davidmpye/snackbot/vmc-host/src/images/doritos_cheese.jpg

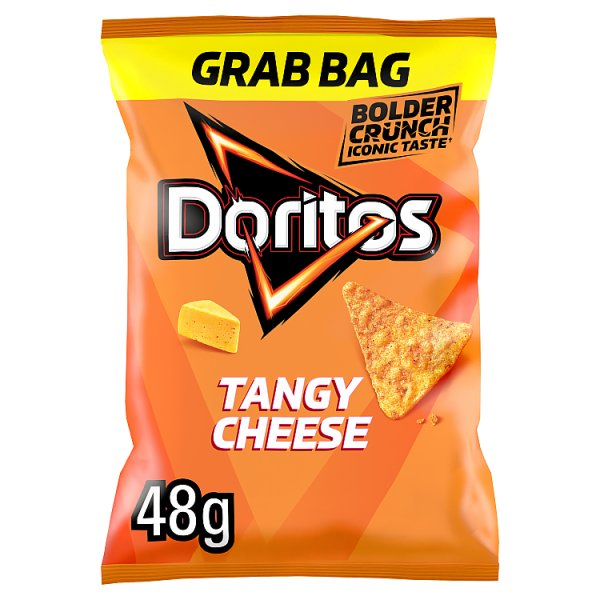
vmc-host/src/images/doritos_cheese.jpg
