davidmpye/snackbot/vmc-host/src/images/chilli_peanuts.jpg

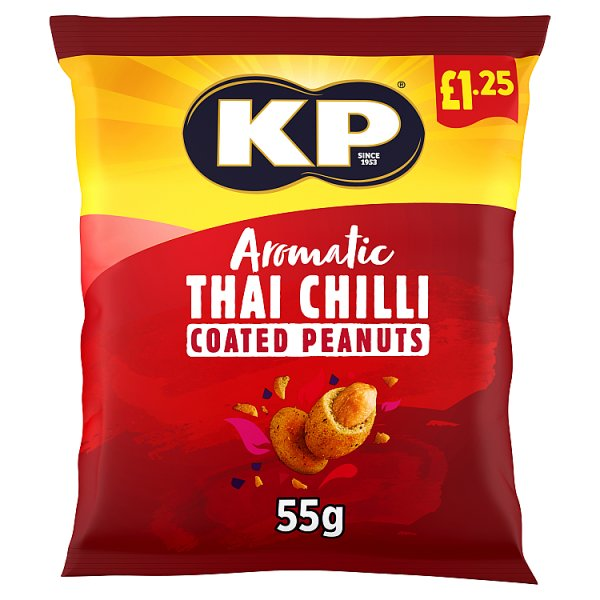
vmc-host/src/images/chilli_peanuts.jpg
