davidmpye/snackbot/vmc-host/src/images/chipsticks.jpg

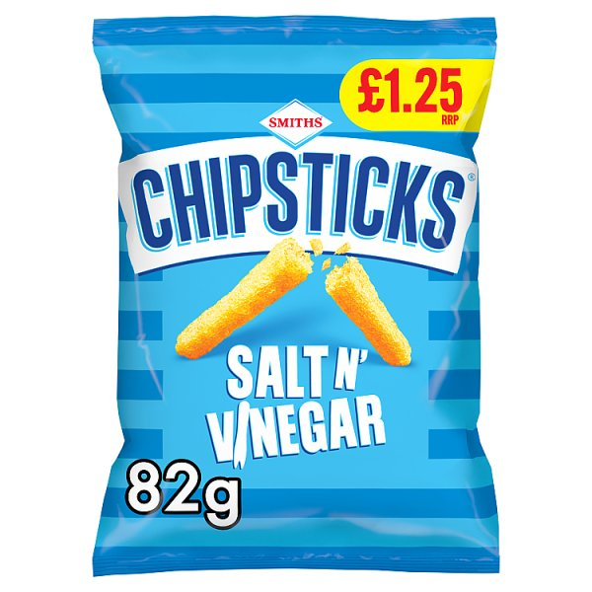
vmc-host/src/images/chipsticks.jpg
