davidmpye/snackbot/vmc-host/src/images/crinklies.jpg

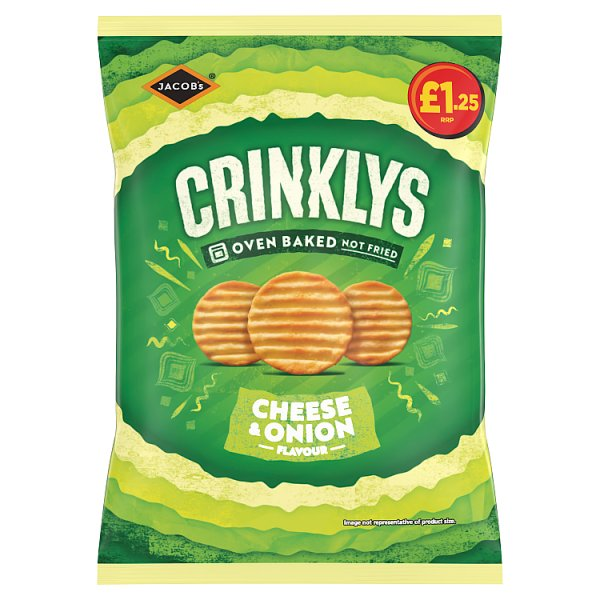
vmc-host/src/images/crinklies.jpg
