davidmpye/snackbot/vmc-host/src/images/doritos_heatwave.jpg

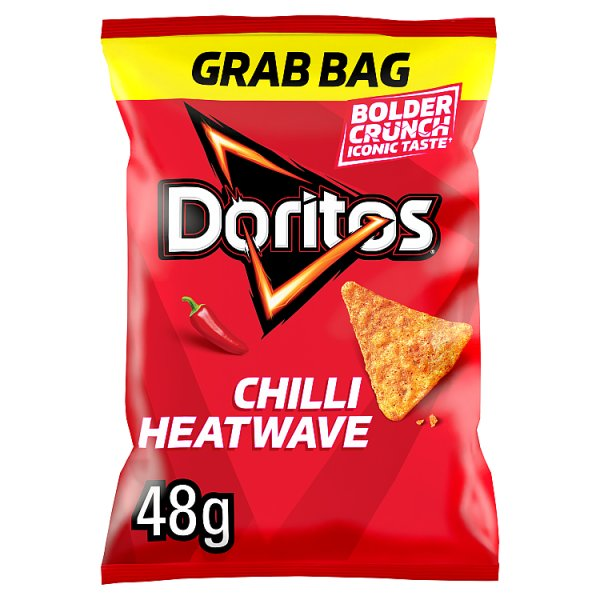
vmc-host/src/images/doritos_heatwave.jpg
