davidmpye/snackbot/vmc-host/src/images/nutrageous.jpg

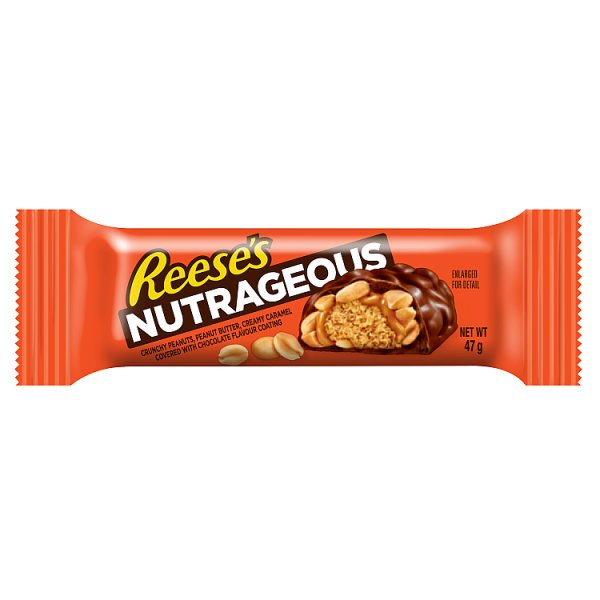
vmc-host/src/images/nutrageous.jpg
