davidmpye/snackbot/vmc-host/src/images/peanut_butter_cups.jpg

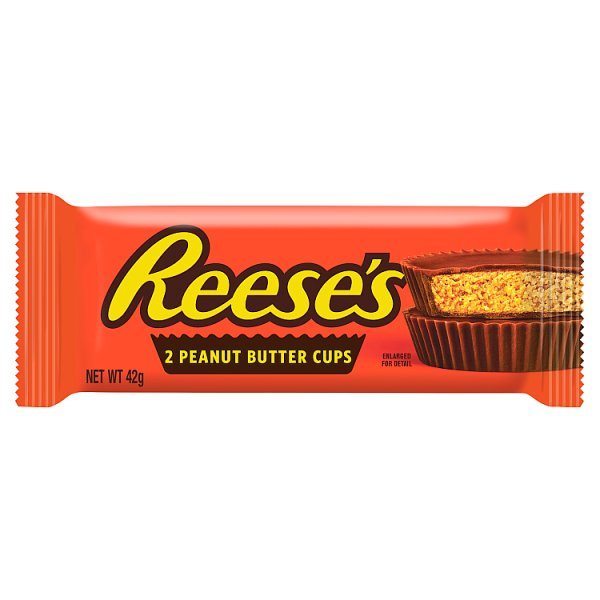
vmc-host/src/images/peanut_butter_cups.jpg
