davidmpye/snackbot/vmc-host/src/images/scampi_fries.jpg

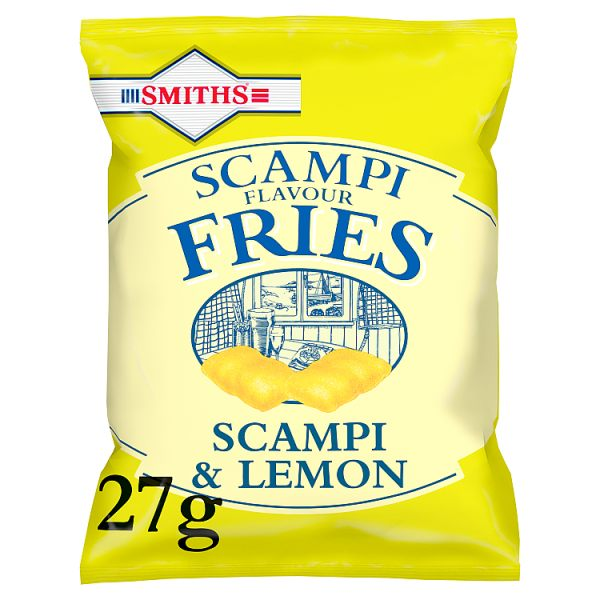
vmc-host/src/images/scampi_fries.jpg
