davidmpye/snackbot/fixings/hyperpixel_lcd_window.scad

square([91, 116]);
//This works!
