davidmpye/snackbot/fixings/i2c_lcd_window.scad

square([89.75, 34.5]);
//This works!
