davidmpye/snackbot/vmc/pcb/pcb.kicad_pcb

## KiCad design vmc/pcb/pcb.kicad_pcb (2025-05-13)

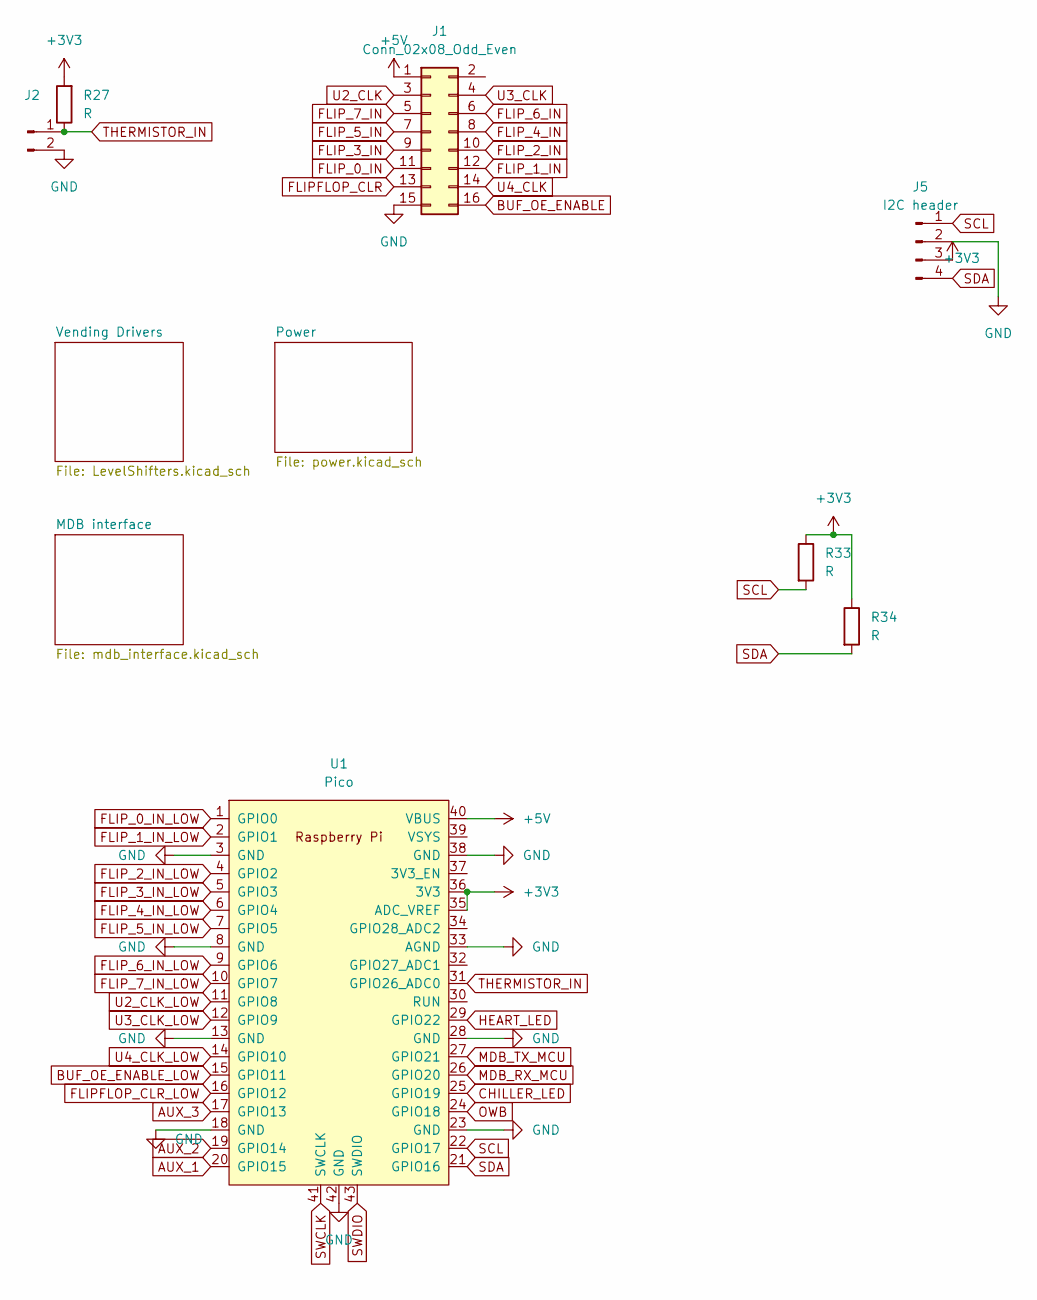
[picture p9: schematic pcb.kicad_sch]

Parts:
J1: Conn_02x08_Odd_Even; PinHeader_2x08_P2.54mm_Vertical
J2: Conn_01x02_Pin; JST_PH_B2B-PH-K_1x02_P2.00mm_Vertical
J5: I2C header; PinHeader_1x04_P2.54mm_Vertical
R27, R33, R34: R; R_1206_3216Metric
U1: Pico; RPi_Pico_SMD_TH

Connections:
+3V3: J5.3, R27.2, R33.1, R34.1, U1.35 (ADC_VREF), U1.36 (3V3); also elsewhere on the board
+5V: J1.1, U1.40 (VBUS); also elsewhere on the board
AUX_1: U1.20 (GPIO15); also elsewhere on the board
AUX_2: U1.19 (GPIO14); also elsewhere on the board
AUX_3: U1.17 (GPIO13); also elsewhere on the board
BUF_OE_ENABLE: J1.16; also elsewhere on the board
BUF_OE_ENABLE_LOW: U1.15 (GPIO11); also elsewhere on the board
CHILLER_LED: U1.25 (GPIO19); also elsewhere on the board
FLIPFLOP_CLR: J1.13; also elsewhere on the board
FLIPFLOP_CLR_LOW: U1.16 (GPIO12); also elsewhere on the board
FLIP_0_IN: J1.11; also elsewhere on the board
FLIP_0_IN_LOW: U1.1 (GPIO0); also elsewhere on the board
FLIP_1_IN: J1.12; also elsewhere on the board
FLIP_1_IN_LOW: U1.2 (GPIO1); also elsewhere on the board
FLIP_2_IN: J1.10; also elsewhere on the board
FLIP_2_IN_LOW: U1.4 (GPIO2); also elsewhere on the board
FLIP_3_IN: J1.9; also elsewhere on the board
FLIP_3_IN_LOW: U1.5 (GPIO3); also elsewhere on the board
FLIP_4_IN: J1.8; also elsewhere on the board
FLIP_4_IN_LOW: U1.6 (GPIO4); also elsewhere on the board
FLIP_5_IN: J1.7; also elsewhere on the board
FLIP_5_IN_LOW: U1.7 (GPIO5); also elsewhere on the board
FLIP_6_IN: J1.6; also elsewhere on the board
FLIP_6_IN_LOW: U1.9 (GPIO6); also elsewhere on the board
FLIP_7_IN: J1.5; also elsewhere on the board
FLIP_7_IN_LOW: U1.10 (GPIO7); also elsewhere on the board
GND: J1.15, J2.2, J5.2, U1.3 (GND), U1.8 (GND), U1.13 (GND), U1.18 (GND), U1.23 (GND), U1.28 (GND), U1.33 (AGND), U1.38 (GND), U1.42 (GND); also elsewhere on the board
HEART_LED: U1.29 (GPIO22); also elsewhere on the board
MDB_RX_MCU: U1.26 (GPIO20); also elsewhere on the board
MDB_TX_MCU: U1.27 (GPIO21); also elsewhere on the board
OWB: U1.24 (GPIO18); also elsewhere on the board
SCL: J5.1, R33.2, U1.22 (GPIO17)
SDA: J5.4, R34.2, U1.21 (GPIO16)
SWCLK: U1.41 (SWCLK); also elsewhere on the board
SWDIO: U1.43 (SWDIO); also elsewhere on the board
THERMISTOR_IN: J2.1, R27.1, U1.31 (GPIO26_ADC0)
U2_CLK: J1.3; also elsewhere on the board
U2_CLK_LOW: U1.11 (GPIO8); also elsewhere on the board
U3_CLK: J1.4; also elsewhere on the board
U3_CLK_LOW: U1.12 (GPIO9); also elsewhere on the board
U4_CLK: J1.14; also elsewhere on the board
U4_CLK_LOW: U1.14 (GPIO10); also elsewhere on the board

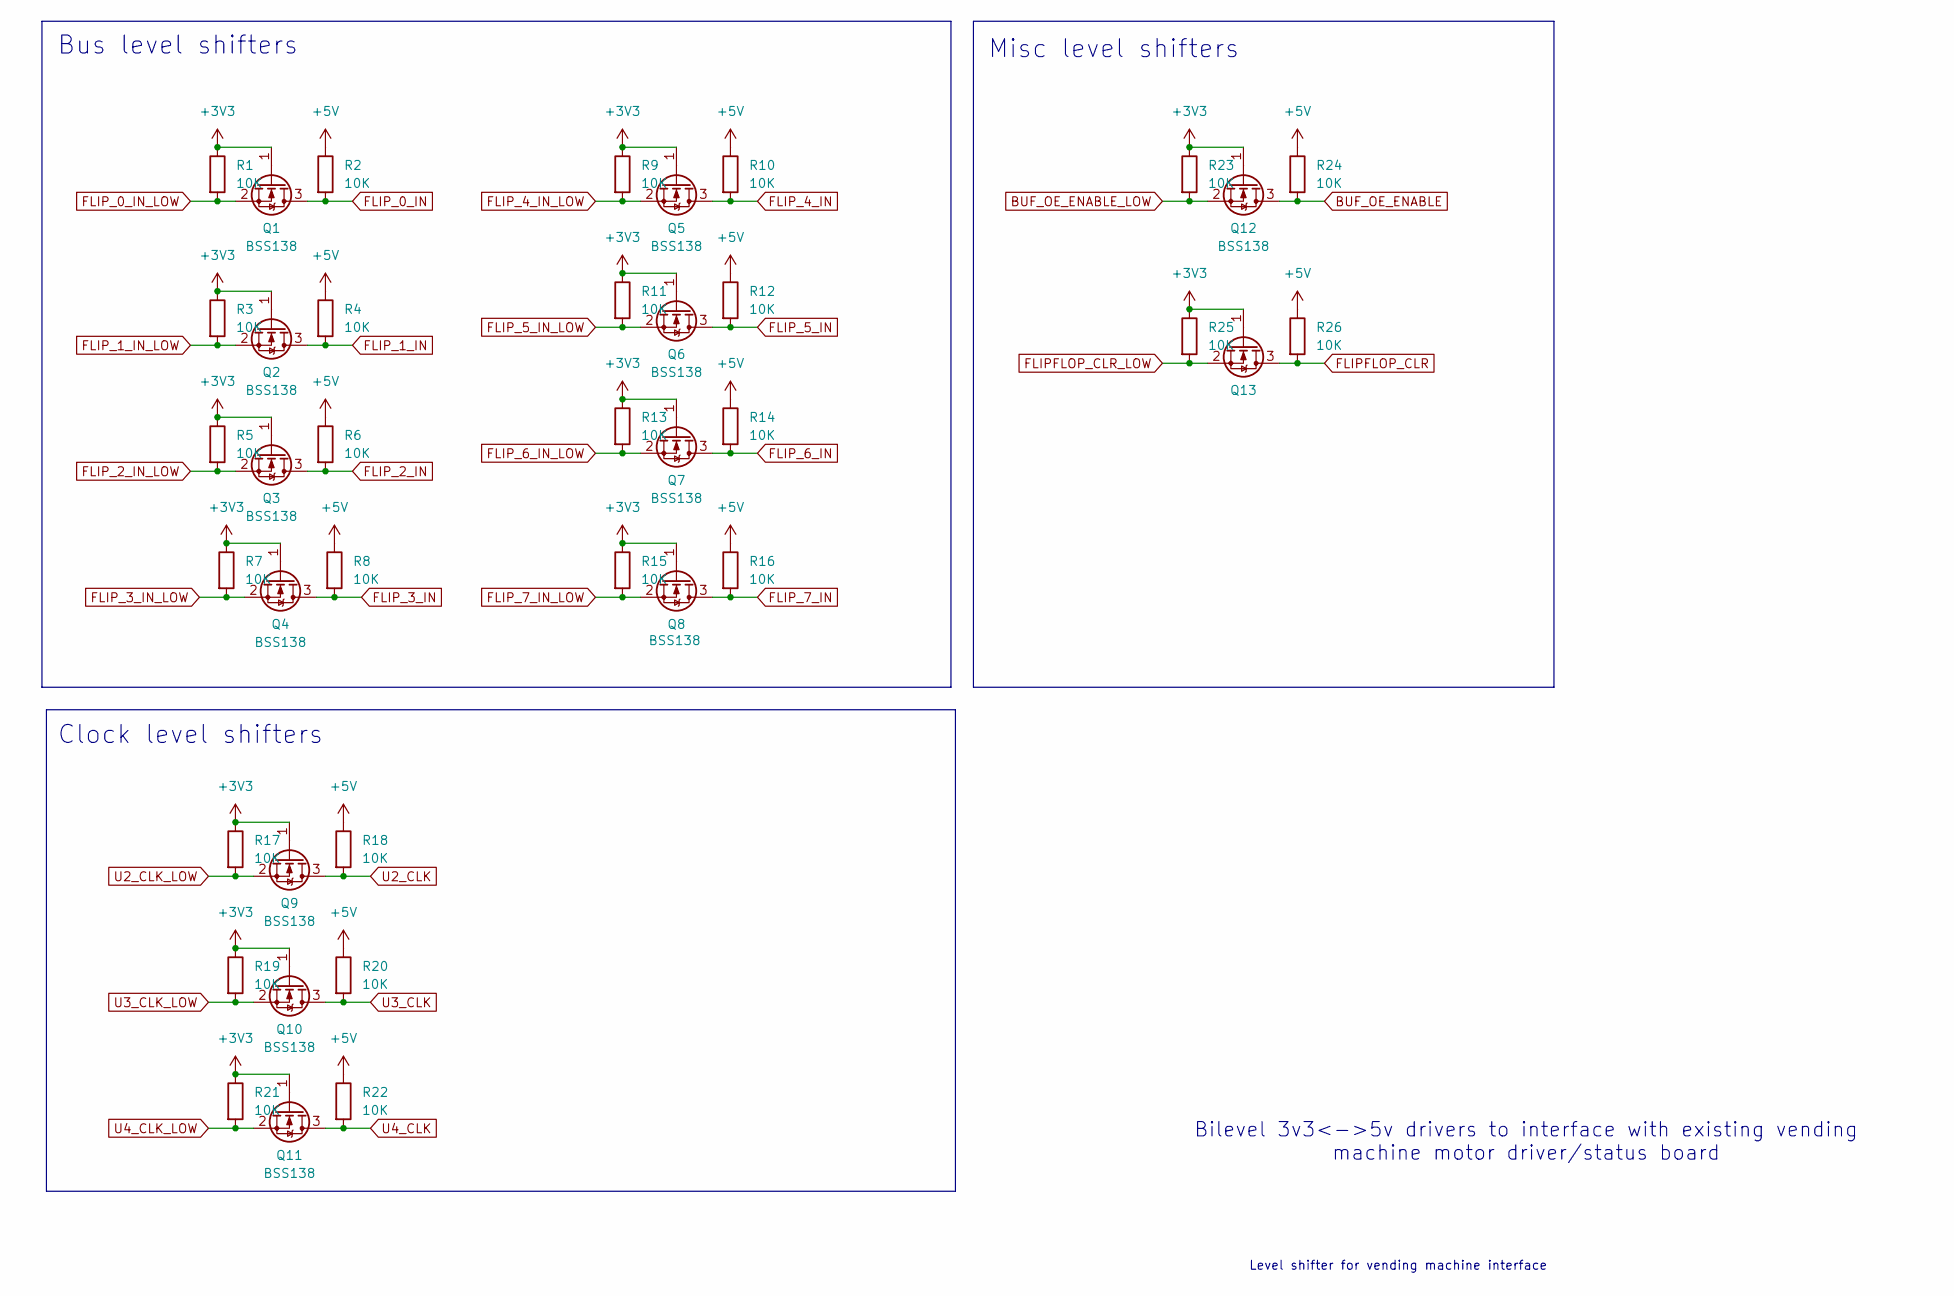
[picture p10: schematic LevelShifters.kicad_sch]

Parts:
Q1, Q2, Q3, Q4, Q5, Q6, Q7, Q8, Q9, Q10, Q11, Q12, Q13: BSS138; SOT-23
R1, R2, R3, R4, R5, R6, R7, R8, R9, R10, R11, R12, R13, R14, R15, R16, R17, R18, R19, R20, R21, R22, R23, R24, R25, R26: 10K; R_1206_3216Metric

Connections:
+3V3: Q1.1 (G), Q2.1 (G), Q3.1 (G), Q4.1 (G), Q5.1 (G), Q6.1 (G), Q7.1 (G), Q8.1 (G), Q9.1 (G), Q10.1 (G), Q11.1 (G), Q12.1 (G), Q13.1 (G), R1.1, R3.1, R5.1, R7.1, R9.1, R11.1, R13.1, R15.1, R17.1, R19.1, R21.1, R23.1, R25.1; also elsewhere on the board
+5V: R2.1, R4.1, R6.1, R8.1, R10.1, R12.1, R14.1, R16.1, R18.1, R20.1, R22.1, R24.1, R26.1; also elsewhere on the board
BUF_OE_ENABLE: Q12.3 (D), R24.2; also elsewhere on the board
BUF_OE_ENABLE_LOW: Q12.2 (S), R23.2; also elsewhere on the board
FLIPFLOP_CLR: Q13.3 (D), R26.2; also elsewhere on the board
FLIPFLOP_CLR_LOW: Q13.2 (S), R25.2; also elsewhere on the board
FLIP_0_IN: Q1.3 (D), R2.2; also elsewhere on the board
FLIP_0_IN_LOW: Q1.2 (S), R1.2; also elsewhere on the board
FLIP_1_IN: Q2.3 (D), R4.2; also elsewhere on the board
FLIP_1_IN_LOW: Q2.2 (S), R3.2; also elsewhere on the board
FLIP_2_IN: Q3.3 (D), R6.2; also elsewhere on the board
FLIP_2_IN_LOW: Q3.2 (S), R5.2; also elsewhere on the board
FLIP_3_IN: Q4.3 (D), R8.2; also elsewhere on the board
FLIP_3_IN_LOW: Q4.2 (S), R7.2; also elsewhere on the board
FLIP_4_IN: Q5.3 (D), R10.2; also elsewhere on the board
FLIP_4_IN_LOW: Q5.2 (S), R9.2; also elsewhere on the board
FLIP_5_IN: Q6.3 (D), R12.2; also elsewhere on the board
FLIP_5_IN_LOW: Q6.2 (S), R11.2; also elsewhere on the board
FLIP_6_IN: Q7.3 (D), R14.2; also elsewhere on the board
FLIP_6_IN_LOW: Q7.2 (S), R13.2; also elsewhere on the board
FLIP_7_IN: Q8.3 (D), R16.2; also elsewhere on the board
FLIP_7_IN_LOW: Q8.2 (S), R15.2; also elsewhere on the board
U2_CLK: Q9.3 (D), R18.2; also elsewhere on the board
U2_CLK_LOW: Q9.2 (S), R17.2; also elsewhere on the board
U3_CLK: Q10.3 (D), R20.2; also elsewhere on the board
U3_CLK_LOW: Q10.2 (S), R19.2; also elsewhere on the board
U4_CLK: Q11.3 (D), R22.2; also elsewhere on the board
U4_CLK_LOW: Q11.2 (S), R21.2; also elsewhere on the board

Notes on the sheet:
Bilevel 3v3<->5v drivers to interface with existing vending machine motor driver/status board
Level shifter for vending machine interface
Clock level shifters
Bus level shifters
Misc level shifters

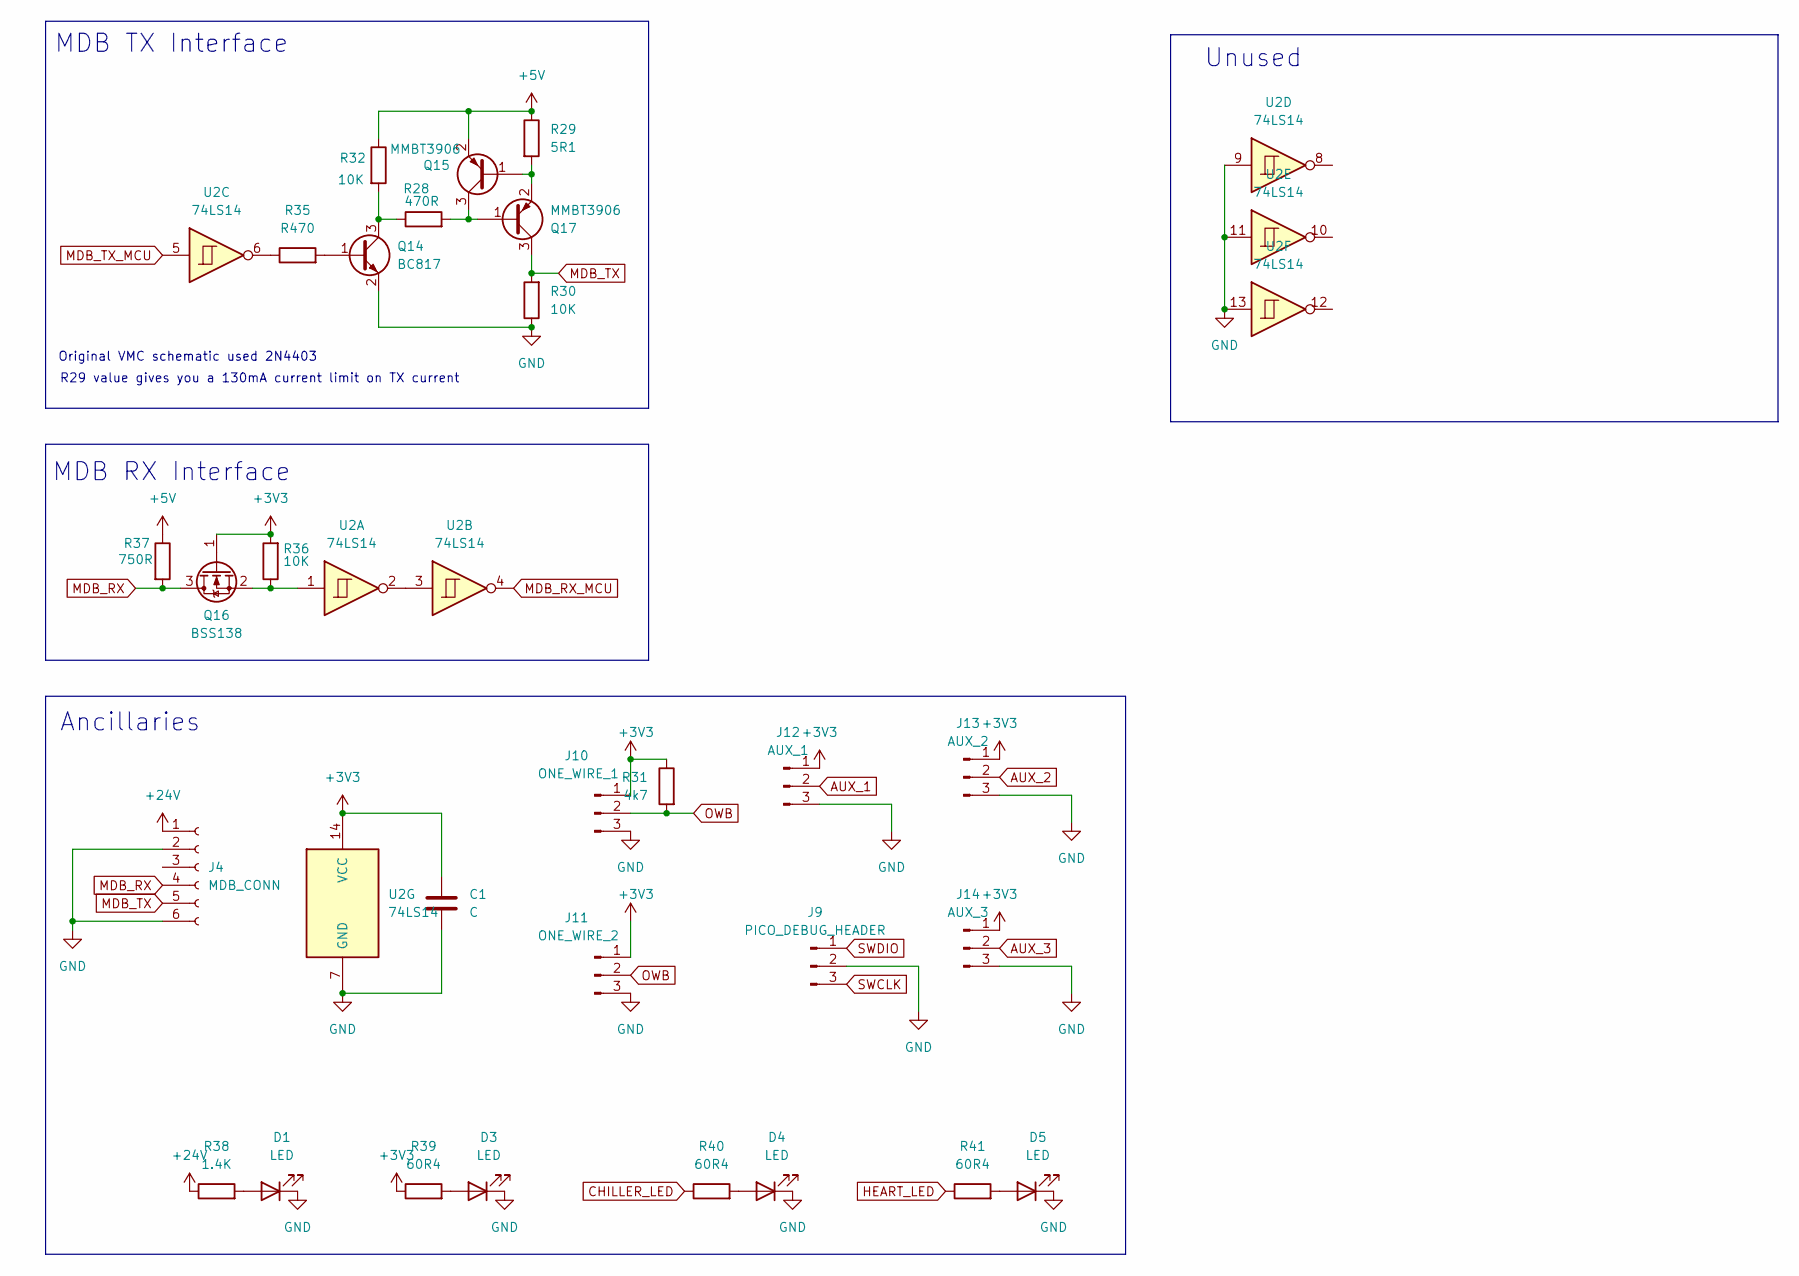
[picture p11: schematic mdb_interface.kicad_sch]

Parts:
C1: C; C_1206_3216Metric
D1, D3, D4, D5: LED; LED_1206_3216Metric_Pad1.42x1.75mm_HandSolder
J4: MDB_CONN; Molex_Mini-Fit_Jr_5566-06A_2x03_P4.20mm_Vertical
J9: PICO_DEBUG_HEADER; PinSocket_1x03_P2.54mm_Vertical
J10: ONE_WIRE_1; JST_PH_B3B-PH-K_1x03_P2.00mm_Vertical
J11: ONE_WIRE_2; JST_PH_B3B-PH-K_1x03_P2.00mm_Vertical
J12: AUX_1; JST_PH_B3B-PH-K_1x03_P2.00mm_Vertical
J13: AUX_2; JST_PH_B3B-PH-K_1x03_P2.00mm_Vertical
J14: AUX_3; JST_PH_B3B-PH-K_1x03_P2.00mm_Vertical
Q14: BC817; SOT-23
Q15, Q17: MMBT3906; SOT-23
Q16: BSS138; SOT-23
R28: 470R; R_1206_3216Metric
R29: 5R1; R_1206_3216Metric
R30, R32, R36: 10K; R_1206_3216Metric
R31: 4k7; R_1206_3216Metric
R35: R470; R_1206_3216Metric
R37: 750R; R_1206_3216Metric
R38: 1.4K; R_1206_3216Metric
R39, R40, R41: 60R4; R_1206_3216Metric
U2: 74LS14; SOIC-14_3.9x8.7mm_P1.27mm

Connections:
+3V3: C1.1, J10.1, J11.1, J12.1, J13.1, J14.1, Q16.1 (G), R31.1, R36.2, R39.1, U2.14 (VCC); also elsewhere on the board
+5V: Q15.2 (E), R29.1, R32.1, R37.1; also elsewhere on the board
+24V: J4.1, R38.1; also elsewhere on the board
AUX_1: J12.2; also elsewhere on the board
AUX_2: J13.2; also elsewhere on the board
AUX_3: J14.2; also elsewhere on the board
CHILLER_LED: R40.1; also elsewhere on the board
GND: C1.2, D1.1 (K), D3.1 (K), D4.1 (K), D5.1 (K), J4.2, J4.6, J9.2, J10.3, J11.3, J12.3, J13.3, J14.3, Q14.2 (E), R30.1, U2.7 (GND), U2.9, U2.11, U2.13; also elsewhere on the board
HEART_LED: R41.1; also elsewhere on the board
MDB_RX: J4.4, Q16.3 (D), R37.2
MDB_RX_MCU: U2.4; also elsewhere on the board
MDB_TX: J4.5, Q17.3 (C), R30.2
MDB_TX_MCU: U2.5; also elsewhere on the board
unnamed: D1.2 (A), R38.2
unnamed: D3.2 (A), R39.2
unnamed: D4.2 (A), R40.2
unnamed: D5.2 (A), R41.2
unnamed: Q14.1 (B), R35.2
unnamed: Q14.3 (C), R28.1, R32.2
unnamed: Q15.1 (B), Q17.2 (E), R29.2
unnamed: Q15.3 (C), Q17.1 (B), R28.2
unnamed: Q16.2 (S), R36.1, U2.1
unnamed: R35.1, U2.6
unnamed: U2.2, U2.3
OWB: J10.2, J11.2, R31.2; also elsewhere on the board
SWCLK: J9.3; also elsewhere on the board
SWDIO: J9.1; also elsewhere on the board

Notes on the sheet:
MDB RX Interface
MDB TX Interface
R29 value gives you a 130mA current limit on TX current
Ancillaries
Unused
Original VMC schematic used 2N4403

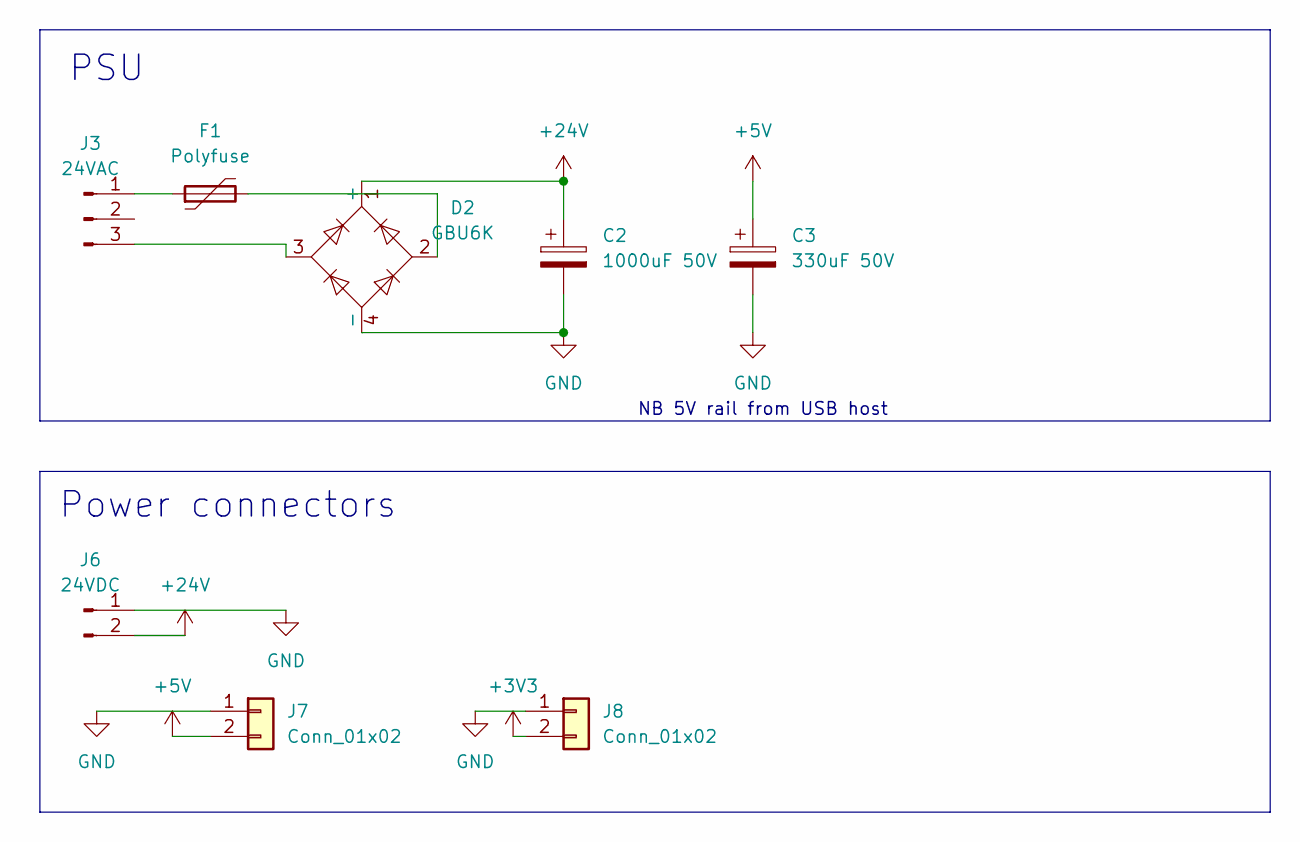
[picture p12: schematic power.kicad_sch]

Parts:
C2: 1000uF 50V; CP_Radial_D12.5mm_P5.00mm
C3: 330uF 50V; CP_Radial_D10.0mm_P5.00mm
D2: GBU6K; Diode_Bridge_Vishay_GBU
F1: Polyfuse; FUS_RKEF300_TYCO_TYC
J3: 24VAC; JST_VH_B3P-VH-B_1x03_P3.96mm_Vertical
J6: 24VDC; JST_VH_B2P-VH_1x02_P3.96mm_Vertical
J7, J8: Conn_01x02; PinHeader_1x02_P2.54mm_Vertical

Connections:
+3V3: J8.2; also elsewhere on the board
+5V: C3.1, J7.2; also elsewhere on the board
+24V: C2.1, D2.1 (+), J6.2; also elsewhere on the board
GND: C2.2, C3.2, D2.4 (-), J6.1, J7.1, J8.1; also elsewhere on the board
unnamed: D2.2, F1.2
unnamed: F1.1, J3.1
unnamed: D2.3, J3.3

Notes on the sheet:
PSU
NB 5V rail from USB host
Power connectors

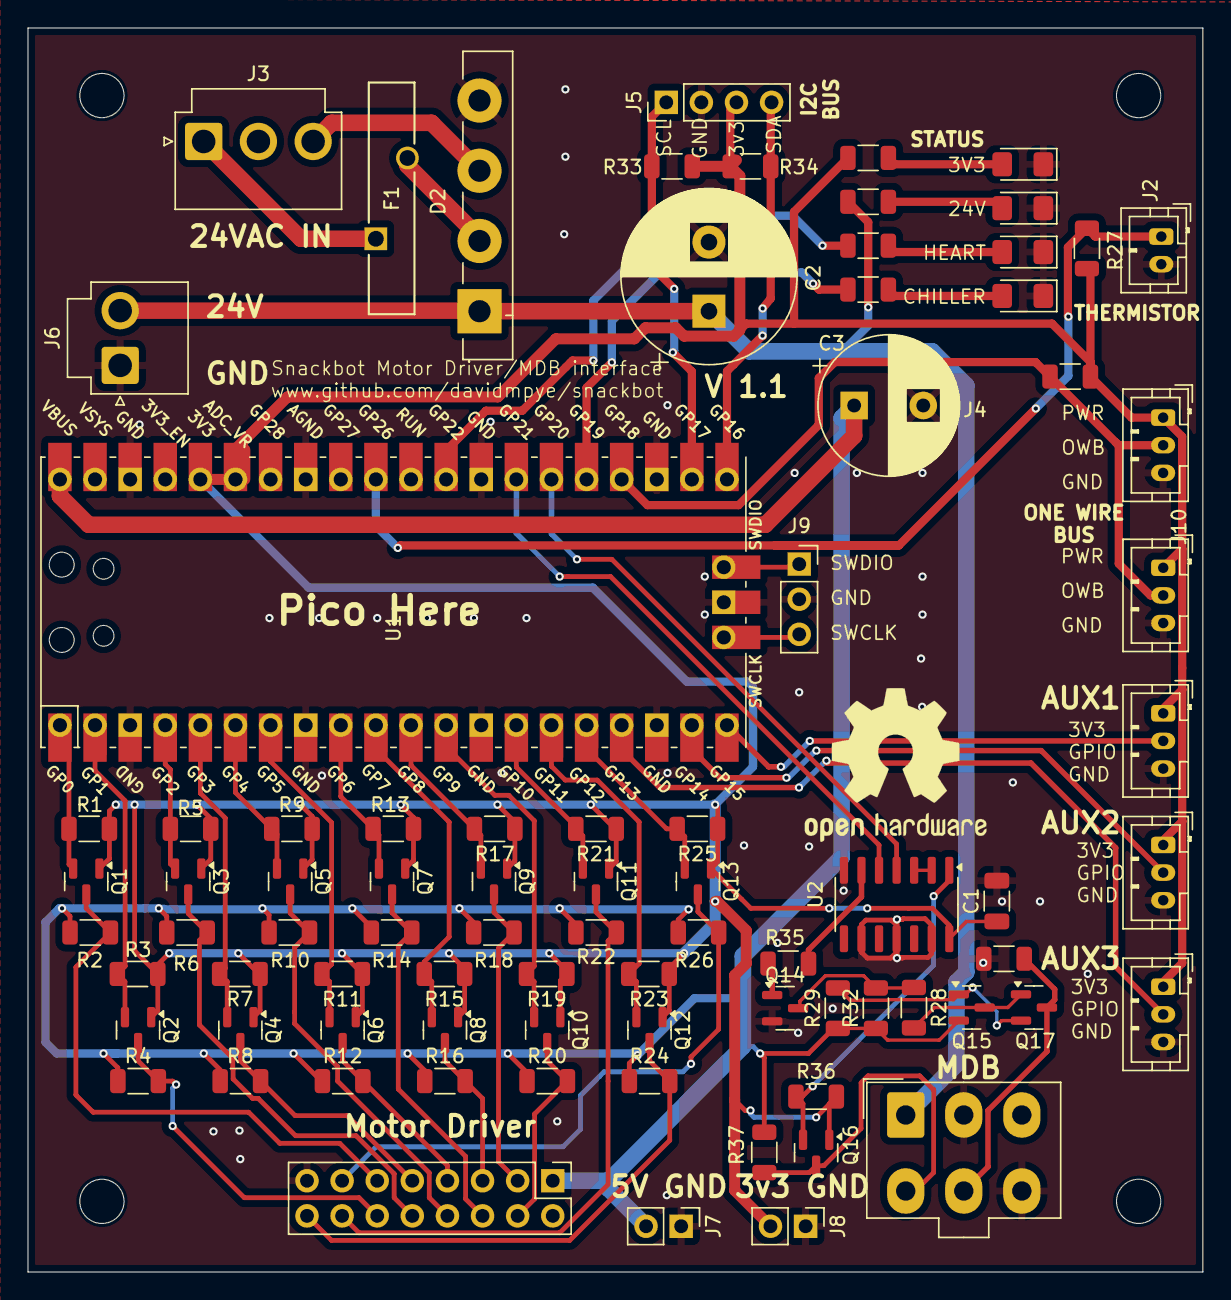
[picture p13: board pcb.kicad_pcb from above]

Board: 2 copper layers, 85.0 x 90.0 mm, 83 parts (0 on the bottom side), 59 nets.
