davidmpye/snackbot/matrix-keyboard/pcb/MembraneKeyboard.kicad_pcb

## KiCad design matrix-keyboard/pcb/MembraneKeyboard.kicad_pcb (2024-12-24)

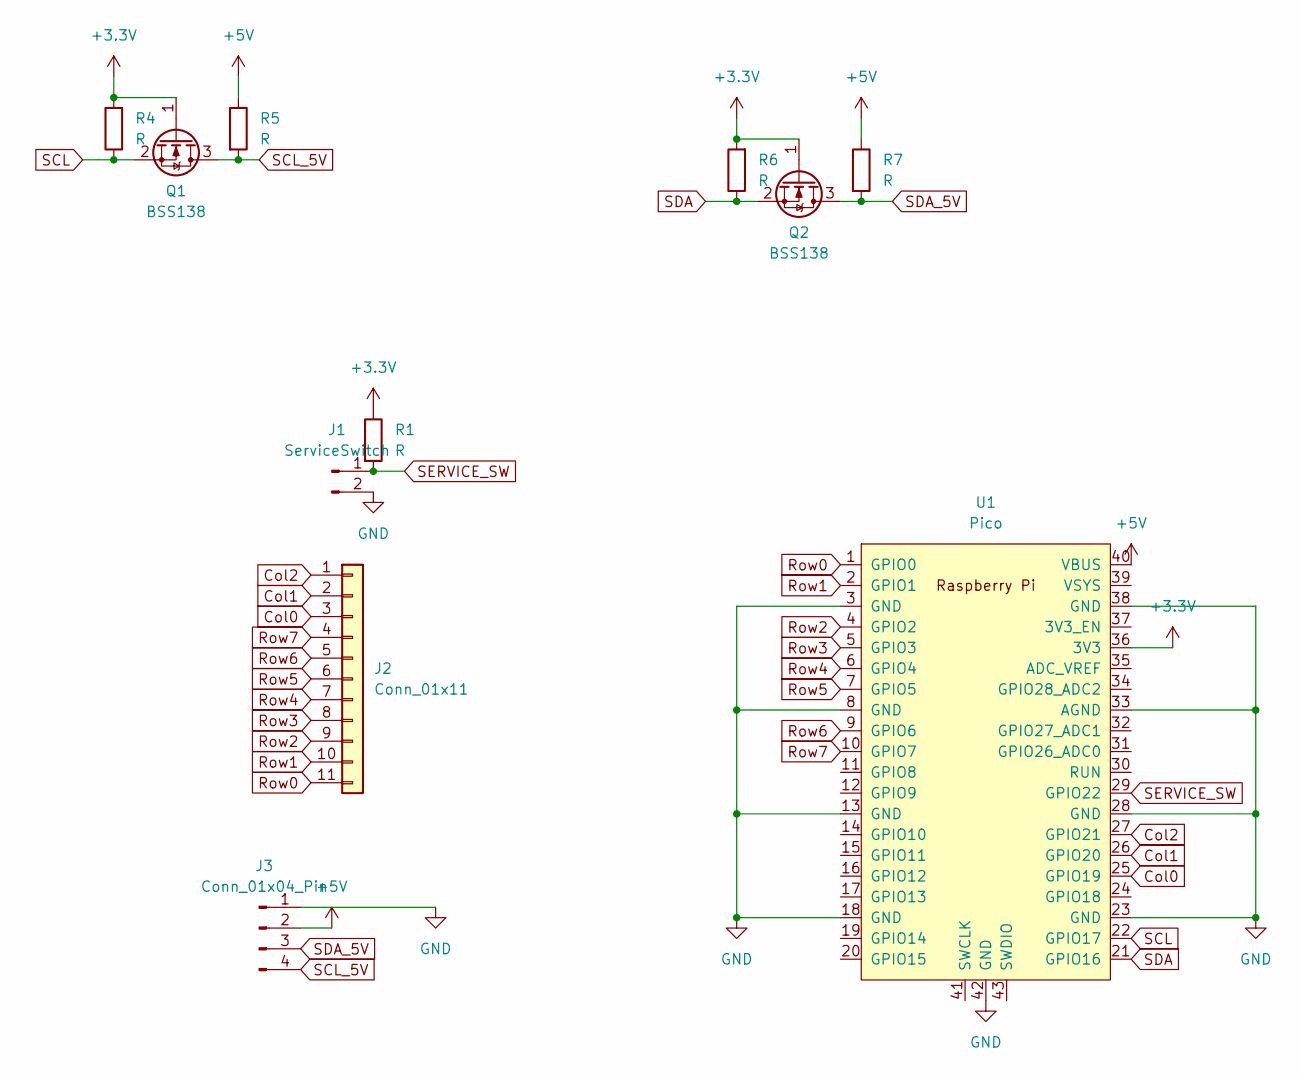
[picture p14: schematic MembraneKeyboard.kicad_sch]

Parts:
J1: ServiceSwitch; PinHeader_1x02_P2.54mm_Vertical
J2: Conn_01x11; PinHeader_1x11_P2.54mm_Vertical
J3: Conn_01x04_Pin; PinHeader_1x04_P2.54mm_Vertical
Q1, Q2: BSS138; SOT-23
R1, R4, R5, R6, R7: R; R_1206_3216Metric
U1: Pico; RPi_Pico_SMD_TH

Connections:
+3.3V: Q1.1 (G), Q2.1 (G), R1.1, R4.2, R6.2, U1.36 (3V3)
+5V: J3.2, R5.1, R7.1, U1.40 (VBUS)
Col0: J2.3, U1.25 (GPIO19)
Col1: J2.2, U1.26 (GPIO20)
Col2: J2.1, U1.27 (GPIO21)
GND: J1.2, J3.1, U1.3 (GND), U1.8 (GND), U1.13 (GND), U1.18 (GND), U1.23 (GND), U1.28 (GND), U1.33 (AGND), U1.38 (GND), U1.42 (GND)
Row0: J2.11, U1.1 (GPIO0)
Row1: J2.10, U1.2 (GPIO1)
Row2: J2.9, U1.4 (GPIO2)
Row3: J2.8, U1.5 (GPIO3)
Row4: J2.7, U1.6 (GPIO4)
Row5: J2.6, U1.7 (GPIO5)
Row6: J2.5, U1.9 (GPIO6)
Row7: J2.4, U1.10 (GPIO7)
SCL: Q1.2 (S), R4.1, U1.22 (GPIO17)
SCL_5V: J3.4, Q1.3 (D), R5.2
SDA: Q2.2 (S), R6.1, U1.21 (GPIO16)
SDA_5V: J3.3, Q2.3 (D), R7.2
SERVICE_SW: J1.1, R1.2, U1.29 (GPIO22)

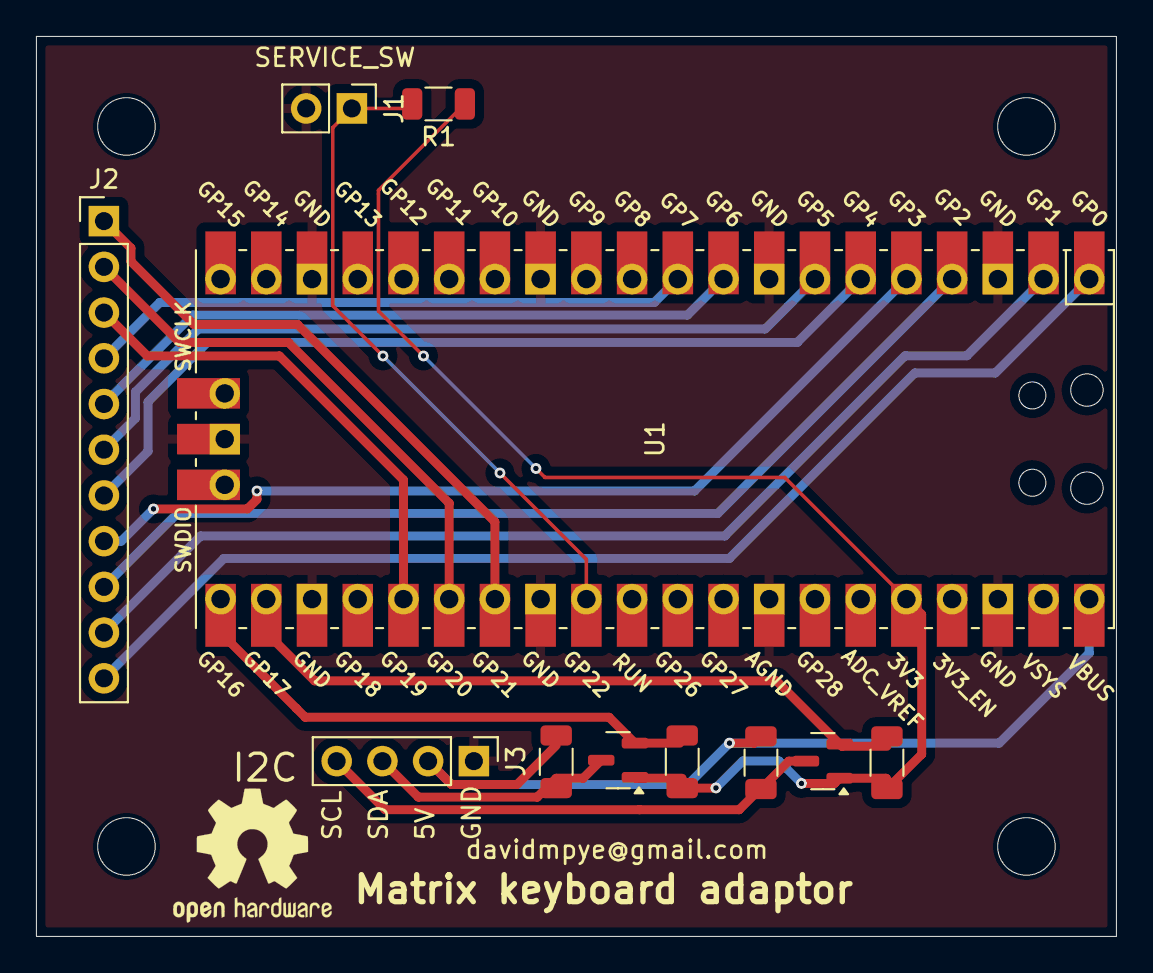
[picture p15: board MembraneKeyboard.kicad_pcb from above]

Board: 2 copper layers, 60.0 x 50.0 mm, 11 parts (0 on the bottom side), 19 nets.
