davidmpye/snackbot/vmc/fw/src/vmc.rs

use embassy_time::{Duration, Timer, with_timeout};
use postcard_rpc::header::VarHeader;

use vmc_icd::{Vend, VendCommand, VendError, VendResult, VendProgress, VendProgressTopic, ItemAvailable, ForceDispense};

use crate::motor_driver::DispenserAddress;

use crate::{AppTx, Sender, SpawnCtx};

use crate::Context;

use defmt::*;

use crate::DISPENSER_DRIVER;
use crate::cashless_device::{CashlessDeviceCommand, CashlessDeviceResponse, CASHLESS_COMMAND_SIGNAL, CASHLESS_RESPONSE_SIGNAL};

static PAYMENT_TIMEOUT:Duration = Duration::from_secs(30);

enum PaymentType {
    Cash(u16),//amount received
    Card(u16),//amount authorised
}

enum PaymentError {
    Cancelled,
    Denied,
    TimedOut,
    DeviceFault,
    NoPaymentDevice,
}

//Spawned in response to the a vend request to handle the process
#[embassy_executor::task]
pub async fn vend_handler(
    _context: SpawnCtx,
    header: VarHeader,
    cmd: VendCommand,
    sender: Sender<AppTx>,
) {
    {
        debug!("Starting vend handler in response to vend request - address {}{}", cmd.row, cmd.col);
        let mut r = DISPENSER_DRIVER.lock().await;
        let driver = r.as_mut().expect("Motor driver must be stored in mutex");
        
        match driver.get_dispenser(DispenserAddress { row: cmd.row as char, col:cmd.col as char}).await {

            Some(dispenser) => {       
                debug!("Obtained dispenser");
                //Check the dispenser is dispensable - if not, we'll return that now.
                match driver.is_dispensable(dispenser) {
                    Ok(()) => {
                        debug!("Dispenser is dispensable, moving to collect payment");
                        //Dispenser exists, now we collect payment
                        let _ = sender.publish::<VendProgressTopic>(header.seq_no, &VendProgress::AwaitingPayment).await;

                        match collect_payment(dispenser.address, cmd.price).await {
                            Ok(payment) => {
                                debug!("Payment accepted, dispensing");
                                //Payment OK, notify topic we are dispensing item
                                let _ = sender.publish::<VendProgressTopic>(header.seq_no, &VendProgress::Dispensing).await;
                                //Dispense item
                                let dispense_result = driver.dispense(dispenser, false).await;
                                match dispense_result {
                                    Ok(_) => {
                                        debug!("Dispensed successfully");
                                        vend_success(dispenser.address, cmd.price).await;   
                                    },
                                    Err(e) => {
                                        error!("Dispense error occurred");
                                        vend_failed(dispenser.address, cmd.price).await;
                                    },
                                }
                                //Return the result to sender
                                match sender.reply::<Vend>(header.seq_no, &dispense_result).await {
                                    Ok(_) => debug!("Vend success reply sent OK"),
                                    Err(_) => error!("Vend success reply did not send")
                                }
                            },
                            Err (e) => {
                                debug!("Payment failed");
                                //Send a Cancel Transaction to make sure that the cardreader isn't still trying
                                //to process the payment, in which case it might succeed in taking payment *after*
                                //we have timed out
                                CASHLESS_COMMAND_SIGNAL.signal(CashlessDeviceCommand::CancelTransaction);
                                match sender.reply::<Vend>(header.seq_no, &Err(VendError::PaymentFailed)).await {
                                    Ok(_) => debug!("Payment reply sent OK"),
                                    Err(_) => error!("Payment reply did not send")
                                }
                                return;
                            }
                        }       
                    }
                    Err(e)=> {
                        debug!("Dispenser is not vendable");
                        match sender.reply::<Vend>(header.seq_no, &Err(e)).await {
                            Ok(_) => debug!("Not vendable reply sent OK"),
                            Err(_) => error!("Not vendable reply did not send")
                        }
                        //propagate error to sender
                        return
                    },
                }
            },
            None => {
                debug!("Invalid dispenser address requested");
                //There is no dispenser at this address - you've asked for an invalid address
                match sender.reply::<Vend>(header.seq_no, &Err(VendError::InvalidAddress)).await {
                    Ok(_) => debug!("Invalid address reply sent OK"),
                    Err(_) => error!("Invalid address reply did not send")
                }
                return
            },
        };
    }
}

async fn collect_payment(addr: DispenserAddress, amount:u16) -> Result<PaymentType, PaymentError> {
    debug!("Sending cashless command signal");
    CASHLESS_COMMAND_SIGNAL.signal(CashlessDeviceCommand::StartTransaction(amount, addr.row as u8, addr.col as u8));
    CASHLESS_RESPONSE_SIGNAL.reset();
    //Now yield
    match with_timeout(PAYMENT_TIMEOUT, CASHLESS_RESPONSE_SIGNAL.wait() ).await {
        Ok(reply) => {
            match reply {
                CashlessDeviceResponse::VendApproved(amount_authorised) => {
                    debug!("Cashless device- Vend approved");
                    if amount == amount_authorised {
                        debug!("Card authorised for {}", amount_authorised);
                        return Ok(PaymentType::Card(amount));
                    }
                    else {
                        error!("Card auth issue - requested {}, got {}", amount, amount_authorised);
                        return Err(PaymentError::Denied);
                    }
                },
                CashlessDeviceResponse::VendDenied => {
                    debug!("Cashless device- Vend denied");
                    return Err(PaymentError::Denied);
                },
                CashlessDeviceResponse::Unavailable => {
                    debug!("Cashless device - no payment device");
                    return Err(PaymentError::NoPaymentDevice);
                }
                _ => { 
                    error!("Unexpected response to collect payment");
                    return Err(PaymentError::DeviceFault);
                }
            }
        },
        Err(_) => {
            debug!("Collect payment timed out");
            return Err(PaymentError::TimedOut);
        }
    }  
}   

#[embassy_executor::task]
pub async fn force_dispense_handler(
    _context: SpawnCtx,
    header: VarHeader,
    cmd: VendCommand,
    sender: Sender<AppTx>,
) {
    let mut r = DISPENSER_DRIVER.lock().await;
    let driver = r.as_mut().expect("Motor driver must be stored in mutex");
        
    match driver.get_dispenser(DispenserAddress { row: cmd.row as char, col:cmd.col as char}).await {
        Some(dispenser) => {       
            //NB we are *skipping* the prevend checks
            let dispense_result = driver.dispense(dispenser, true).await;                
            match sender.reply::<ForceDispense>(header.seq_no, &dispense_result).await {
                Ok(_) => debug!("Vend dispense reply sent OK"),
                Err(_) => error!("Vend dispense reply did not send"),
            }
        }
        None => {
            //There is no dispenser at this address - you've asked for an invalid address
            match sender.reply::<ForceDispense>(header.seq_no, &Err(VendError::InvalidAddress)).await {
                Ok(_) => debug!("Invalid address reply sent OK"),
                Err(_) => error!("Invalid address reply did not send")
            }
        }    
    }      
}


#[embassy_executor::task]
pub async fn item_available_handler(
    _context: SpawnCtx,
    header: VarHeader,
    cmd: VendCommand,
    sender: Sender<AppTx>,
) {
    let mut r = DISPENSER_DRIVER.lock().await;
    let driver = r.as_mut().expect("Motor driver must be stored in mutex");
        
            
    match driver.get_dispenser(DispenserAddress { row: cmd.row as char, col:cmd.col as char}).await {
        Some(dispenser) => match sender.reply::<ItemAvailable>(header.seq_no, &driver.is_dispensable(dispenser)).await {
            Ok(_) => debug!("Vend dispense reply sent OK"),
            Err(_) => error!("Vend dispense reply did not send"),
        }
        None => {
            match sender.reply::<ItemAvailable>(header.seq_no, &Err(VendError::InvalidAddress)).await {
                Ok(_) => debug!("Invalid address reply sent OK"),
                Err(_) => error!("Invalid address reply did not send")
            }
        }
    }
}


async fn vend_success(addr: DispenserAddress, amount:u16) {
    //For now we assume we're using cashless, but we need to be smart and handle coin stuff one day
    CASHLESS_COMMAND_SIGNAL.signal(CashlessDeviceCommand::VendSuccess(addr.row as u8, addr.col as u8));
    //Cashless device will handle the end session process
}   

async fn vend_failed(addr: DispenserAddress, amount:u16) {
    //if card payment, cancel
    CASHLESS_COMMAND_SIGNAL.signal(CashlessDeviceCommand::VendFailed);
}

pub async fn cancel_vend_handler(_context: &mut Context, _header: VarHeader, _cmd: ()) {

}
