davidmpye/snackbot/vmc/fw/src/watchdog.rs

use embassy_rp::watchdog::Watchdog;
use embassy_rp::peripherals::WATCHDOG;
use embassy_time::{Duration, Timer};
use embassy_rp::gpio::Output;

const WATCHDOG_TIMER_SECS:u64 = 2;
const WATCHDOG_FEED_TIMER_MS:u64 = 250;

#[embassy_executor::task]
pub async fn watchdog_task(watchdog: WATCHDOG, mut heartbeat_pin: Output<'static>) -> ! {
    let mut dog = Watchdog::new(watchdog);
    dog.start(Duration::from_secs(WATCHDOG_TIMER_SECS));
    loop {        
        dog.feed();
        Timer::after(Duration::from_millis(WATCHDOG_FEED_TIMER_MS)).await;
        heartbeat_pin.toggle();
    }
}
