davidmpye/snackbot/(commit log)

2024-12-24 initial import of keyboard matrix driver and pcb
    [MembraneKeyboard.kicad_pcb, MembraneKeyboard.kicad_sch]
2024-12-24 Add 3d printed and laser cut fixings
    [hyperpixel_lcd_window.scad, hyperpixel_mount.scad, hyperpixel_retaining_tabs.scad, i2c_lcd_frame.scad, i2c_lcd_window.scad]
2024-12-25 Initial work to bring I2C LCD functionality in
2024-12-26 Add i2c lcd library + make i2c init function return if hw not found
2024-12-26 Fix return type typo
    [main.rs]
2025-01-05 Service mode switch handler added
2025-01-05 Update lib.rs
    Remove unused serde serialize/de traits.
2025-01-05 Correct GPIO pin used for service sw, and change product descriptor
    [main.rs]
2025-01-08 Use fixedstr and collapse icd to use a single setText method to set both lines
    [lib.rs, main.rs]
2025-01-10 Start implementation of motor driver
2025-01-12 Add new error of InvalidAddress and use interrupt driven waits on motor-moving GPIOs, along with embassy timeouts
    [lib.rs, main.rs]
2025-01-13 Fix motor-off logic
2025-01-13 Move motor driver struct behind a mutex
2025-01-15 Reformat wiring comments and change calculate drive bytes to use Result rather than Option
2025-01-15 Fix for microswitch bouncing issue
    [motor_driver.rs]
2025-01-16 Further implementation of VMC driver
2025-01-24 Add 9-bit-uart-async to list
2025-01-26 Revert "Initial skeleton structure for VMC MDB functionality"
    This reverts commit c82a2cb734b8dbab710b992cda3d5d9fe2628658.
    [main.rs, motor_driver.rs]
2025-01-27 Split USB code off into device hander rs file
2025-01-28 Move USB driver chatter to 'debug' level
2025-01-29 Fixes to make vmc-host compile again
    [main.rs, vmc_driver.rs]
2025-02-05 Rework structure to use gtk4
    [main.rs]
2025-02-19 Updates to shim to support LCD driver
2025-02-19 Updates to shim/driver structure
2025-03-02 Start refactoring into driver tasks
2025-03-12 Initial import of steinhart hart driver
2025-03-13 Fix clippy warnings in keyboard fw Make main fw compile again
    [chiller_driver.rs, lib.rs, main.rs, motor_driver.rs]
2025-03-13 More updates to chiller driver - set up vals as const where this makes sense
2025-03-13 Tidying of chiller driver
2025-03-13 Add the PCB for the VMC
    [LevelShifters.kicad_sch, mdb_interface.kicad_sch, pcb.kicad_pcb, pcb.kicad_sch, power.kicad_sch, untitled.kicad_sch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]
2025-03-13 Reorder init to avoid panic when chiller task was initialised before motor driver...
    [main.rs]
2025-03-14 Updated PCB to thicken i2c data tracks and reroute the 24v led feed
    [pcb.kicad_pcb]
2025-03-14 Fix missing ground connection on shift register IC (ground plane continuity failure)
    [pcb.kicad_pcb]
2025-03-14 More layout tweaks
    [pcb.kicad_pcb]
2025-03-16 Rename coin acceptor Add watchdog Improve PCB track routing
2025-03-16 As per last commit
    [mdb_interface.kicad_sch, pcb.kicad_sch]
2025-03-19 Screen driver updates
2025-04-01 Add resistor values
    [mdb_interface.kicad_sch, pcb.kicad_pcb]
2025-04-01 Make watchdog toggle the heartbeat led
2025-04-02 Add code to drive chiller state LED from task
2025-04-03 New thermistor calculations
2025-04-03 Remove coin acceptor error message for now try 3.3k thermistor constants
    [chiller_driver.rs, coin_acceptor.rs]
2025-04-04 Remove more clippy errors
    [coin_acceptor.rs, main.rs, watchdog.rs]
2025-04-04 Add safety to disable chiller if thermistor reading invalid
2025-04-04 Add version number to PCB (v1.1) Whitespace formatting
    [mdb_interface.kicad_sch, pcb.kicad_pcb]
2025-04-12 Add cashless device driver
2025-04-16 Move motor driver silkscreen label
    [pcb.kicad_pcb]
2025-04-26 Add timer so make another selection box is transitory
2025-04-30 Update 5R to 5R1
    [mdb_interface.kicad_sch]
2025-05-01 Update schematic to use correct 60R4 resistor values Update stock info
    [mdb_interface.kicad_sch]
2025-05-02 Start to do the wiring to make the cashless device work
2025-05-06 Refactor cashless device to use separate poll task and event handlers
2025-05-06 Remove excess poll debug noise
    [cashless_device.rs]
2025-05-09 Initial redraft of cashless device architecture
2025-05-13 Set device enabled
2025-05-13 Fixes to endpoint names
    [cashless_device.rs]
2025-05-13 Fix lack of format trait
    [cashless_device.rs]
2025-05-13 Fix bug with dispense errors not being noted
    [rpc_shim.rs, vmc_driver.rs]
2025-05-14 Debug error sending cashless commands
    [lib.rs, main.rs, vmc_driver.rs]
2025-05-19 Update crates and fix more clippy
    [cashless_device.rs]
2025-05-20 Fix problem with poll delay fn NOT being inside 'main lop
    [cashless_device.rs]
2025-05-27 Change to 2.2k thermistor
2025-05-29 Clear selected item at end of vend (regardless of success or failure
    [main.rs]
2025-05-29 Fix another place where item not getting cleared
    [main.rs]
2026-10-07 Send cancel transaction message to card reader in the event of an error, to make sure it doesn't bill people in a timeout state
    [vmc.rs]
2026-11-07 Ensure cashless device is initialised
